chrische-xx/caravel_user_project_analog/README.md

# 8-bit SAR-ADC with offset calibration

This is a mixed-mode project featuring a 8-bit SAR-ADC, with offset calibration.
The logic section is synthesized using the openlane digital flow.

## Silicon Measurements 

Measurement results from the first measured die that was taped-out on the [MPW3 Shuttle](https://platform.efabless.com/shuttles/MPW-3)

```
Measurement Conditions:
AVDD=1.5V
DVDD=1.5V
VCM=0.75V
No offset calibration.
```

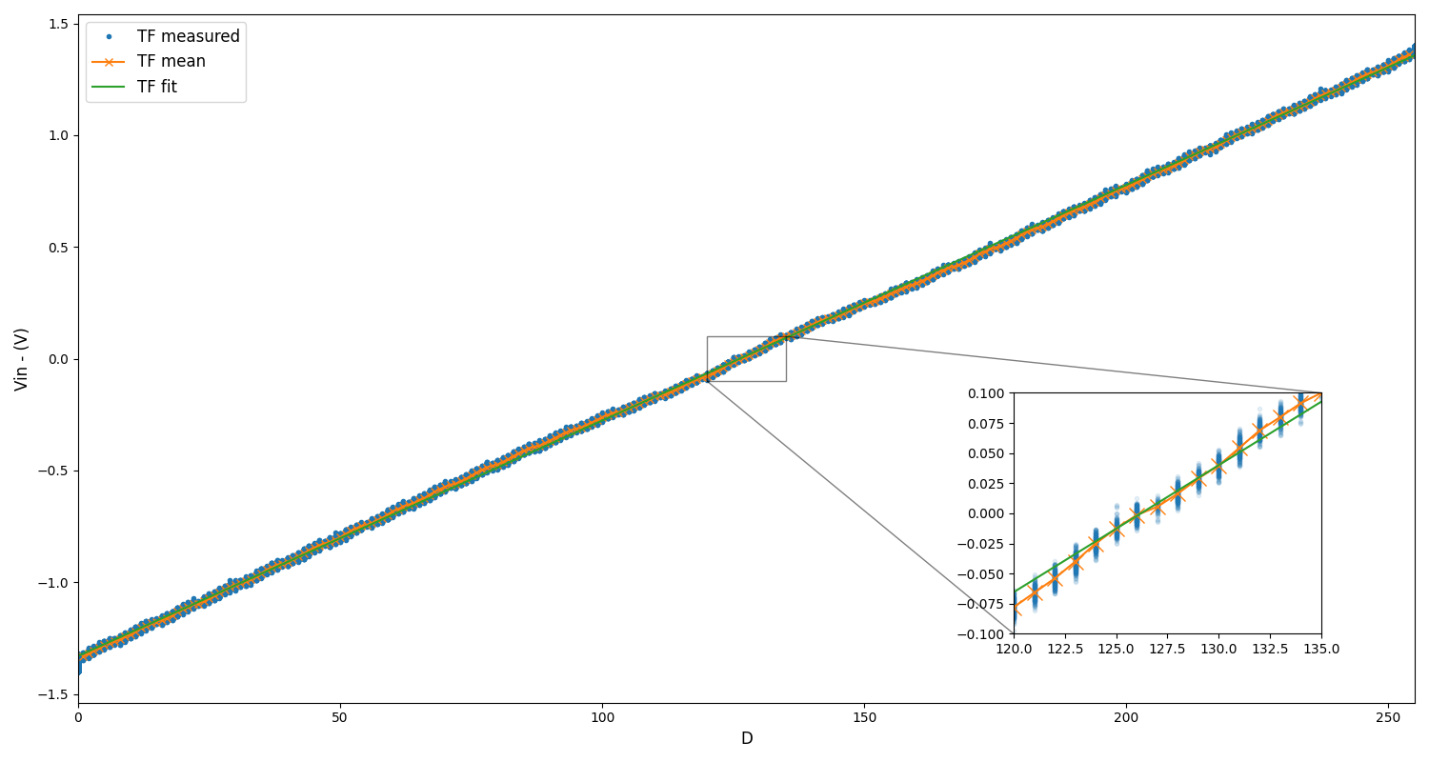
[picture p1: docs/pictures/silicon/tf.png]
TF


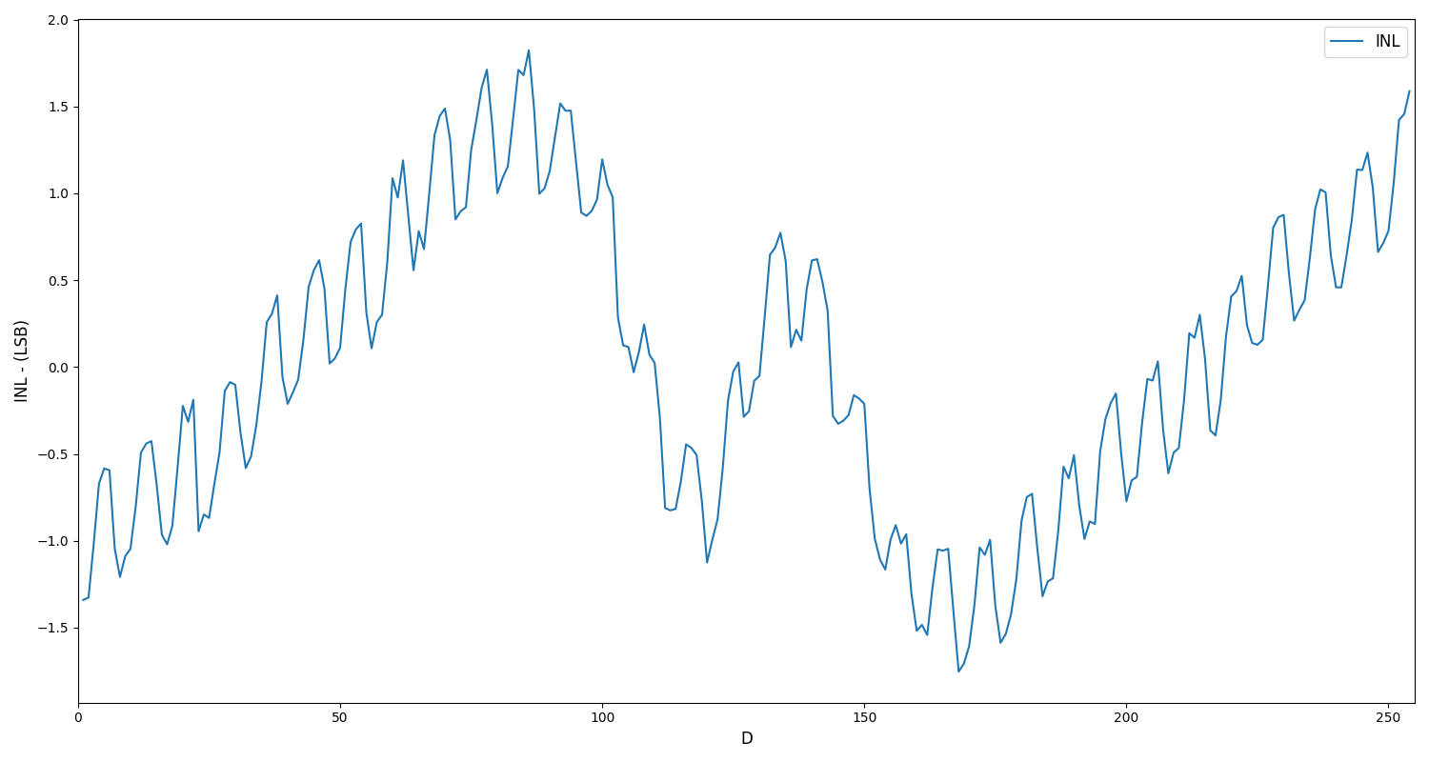
[picture p2: docs/pictures/silicon/inl.png]
INL


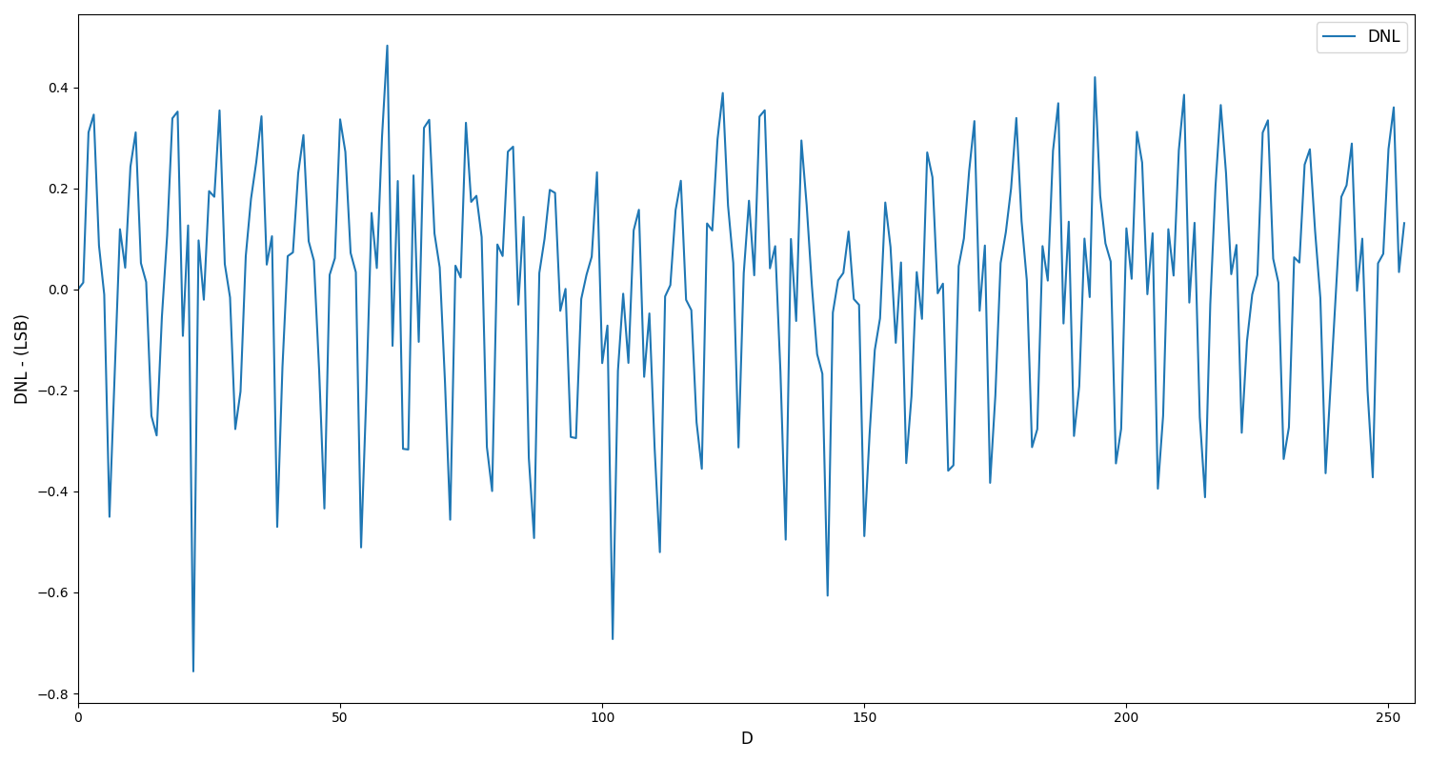
[picture p3: docs/pictures/silicon/dnl.png]
DNL


## Layout

The layout is created using magic as a pcell generator and drc checker, while the 
connection of the design is done using klayout.

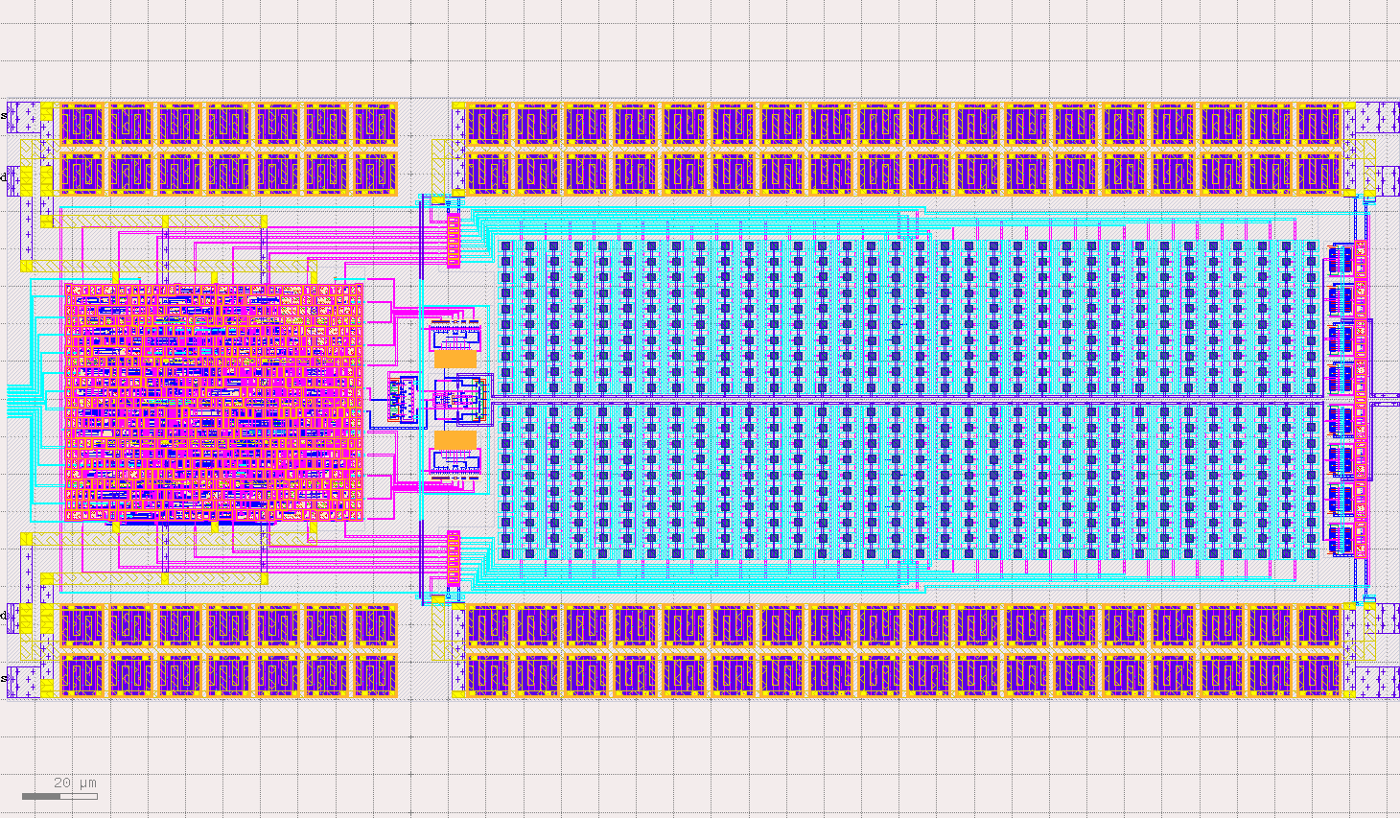
[picture p4: docs/layout.png]
layout


## Architecture

The ADC is composed of a differential top-plate sampled dac, which is made from an array of MIM capacitors.
The comparator is a regenerative comparator, which is followed by a latch to retain the output state during
reset. The latch output is fed into the logic section, which performs the standard binary search algorithm. 

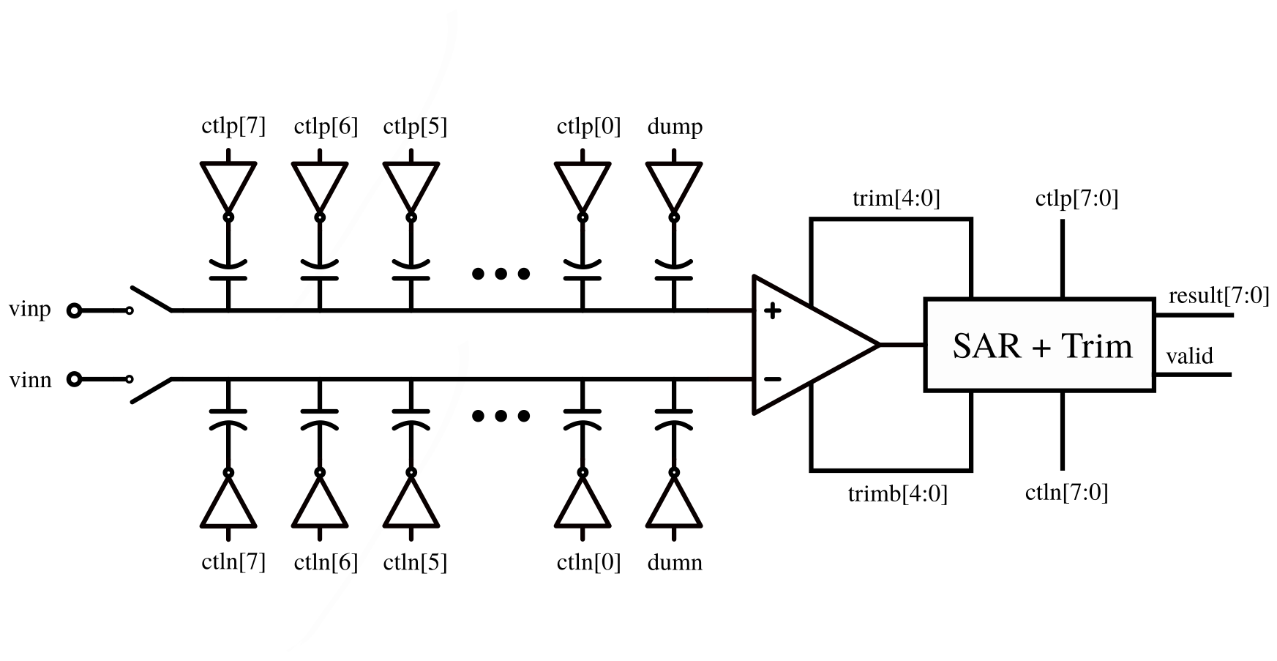
[picture p5: docs/pictures/architecture.png]


## Simulation

The simulation is carried out using ngspice using the mixed-mode xspice capabilities.
The digital section is synthesized using yosys that can then be bridged to/from the
analog section.

The Schematics are created using xschem, which also serves as the simulation framework.
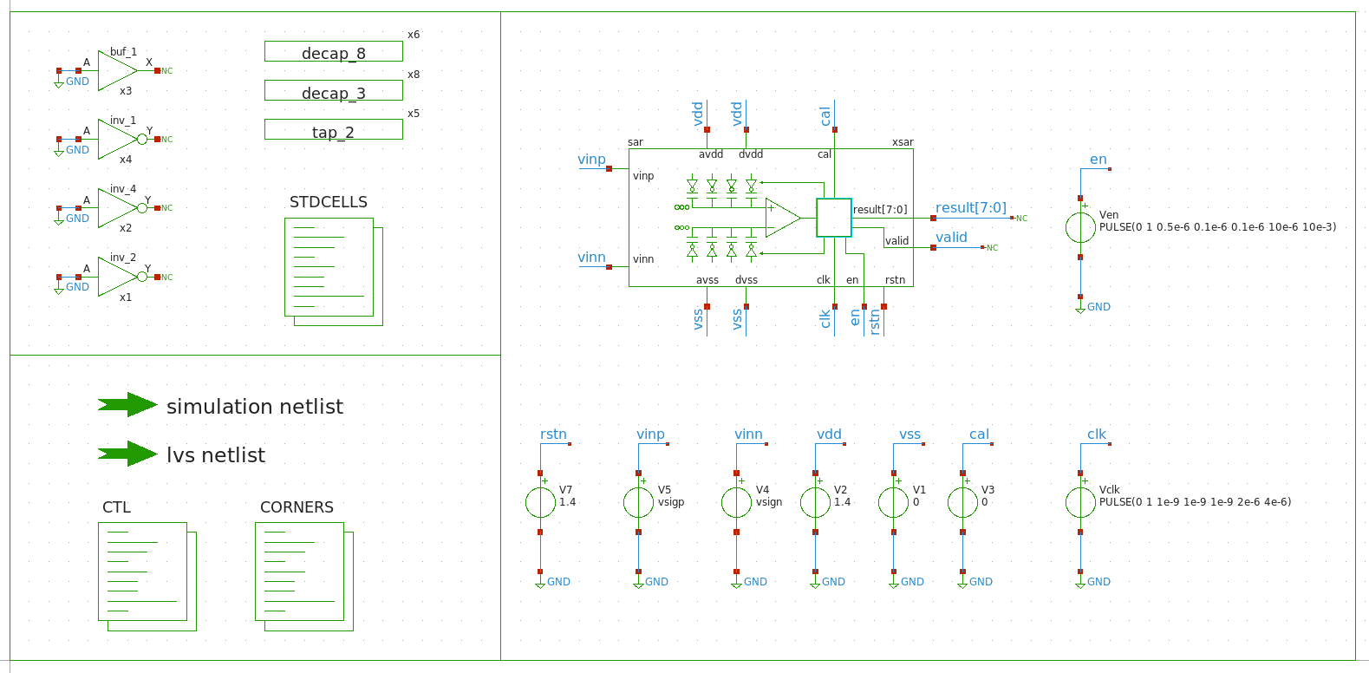
[picture p6: docs/pictures/xschem.png]


The SAR schematic:
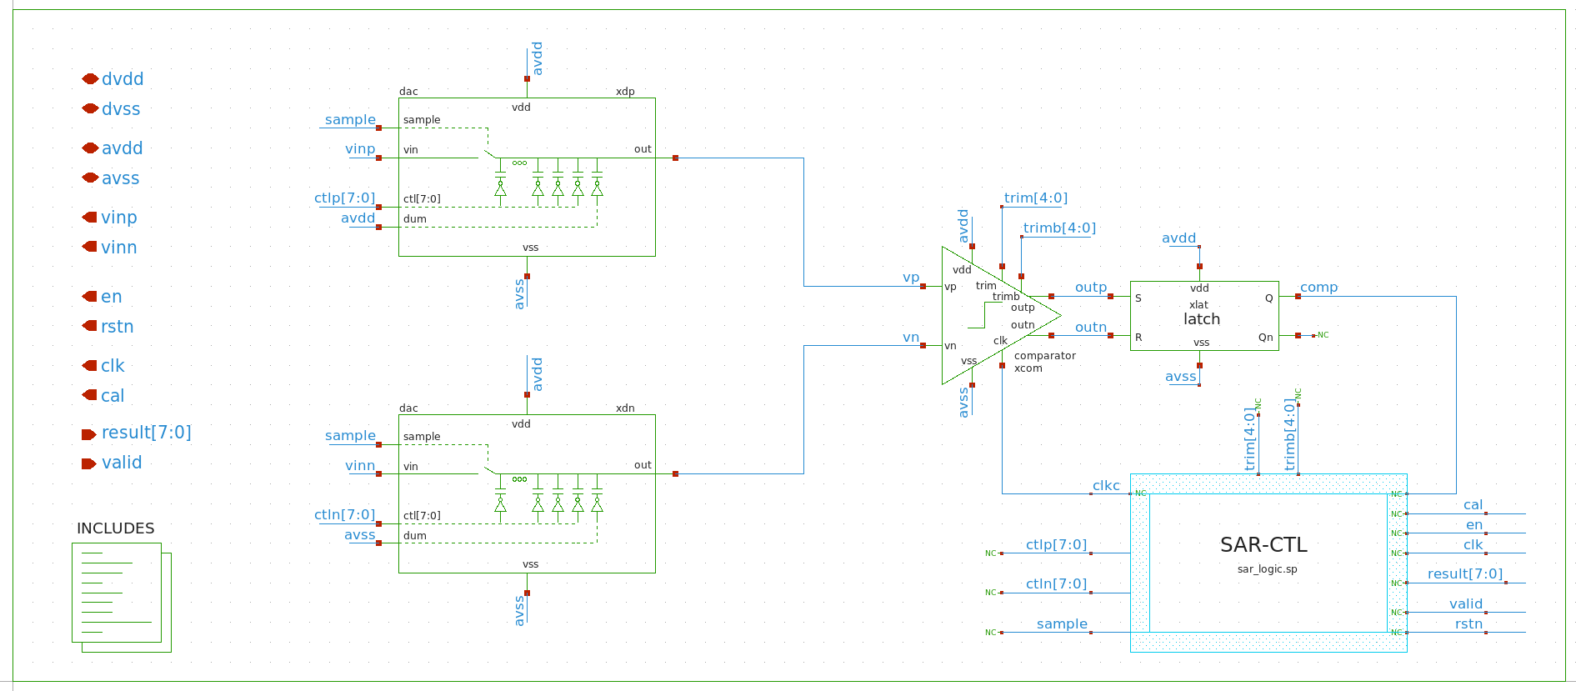
[picture p7: docs/pictures/sar.png]


The simulation output can then be viewed in both analog and digital domain.

Digital waveforms displayed using GTKWave
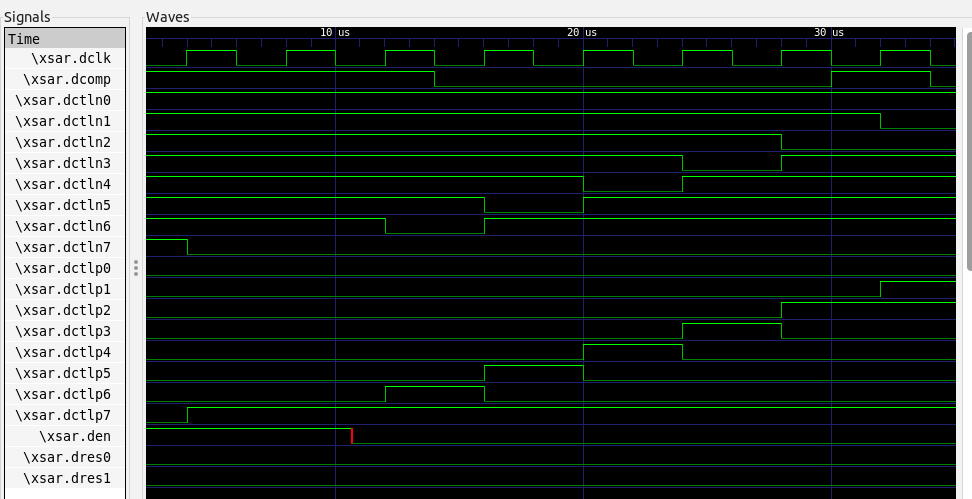
[picture p8: docs/pictures/gtkwave.png]
gtkwave


Analog waveforms displayed using Gnuplot in interactive mode.
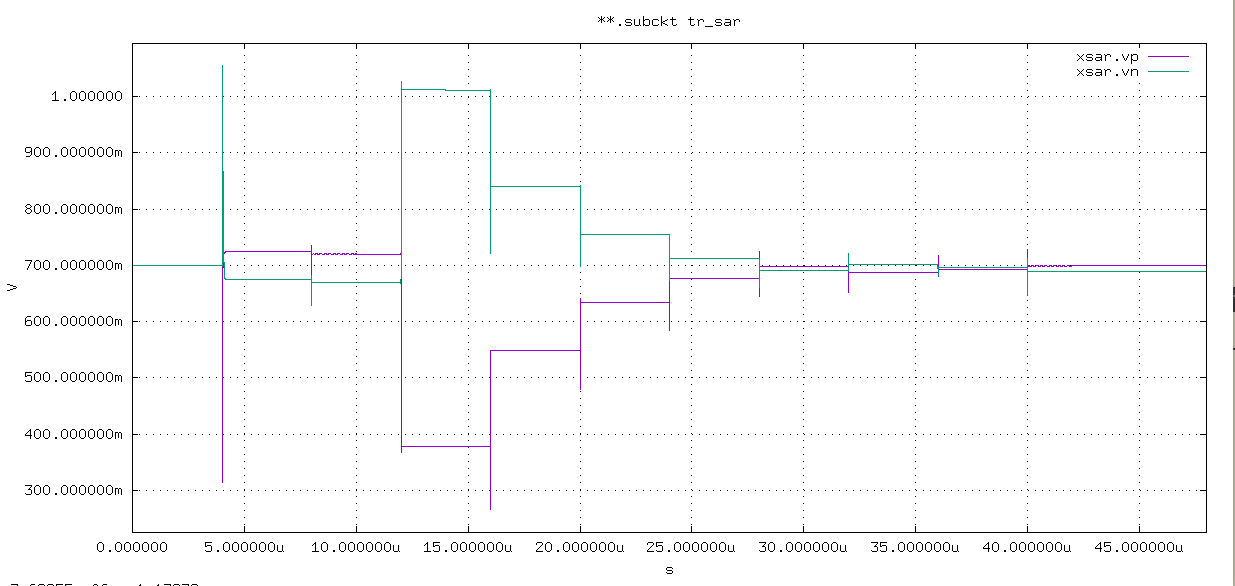
[picture p9: docs/pictures/gnuplot.png]
