chrische-xx/caravel_user_project_analog/xschem/sar/control/sar_logic.sp

* SPICE netlist generated by Yosys 0.8 (git sha1 5706e90)

.SUBCKT sar_logic clk rstn en comp cal valid result.0 result.1 result.2 result.3 result.4 result.5 result.6 result.7 sample ctlp.0 ctlp.1 ctlp.2 ctlp.3 ctlp.4 ctlp.5 ctlp.6 ctlp.7 ctln.0 ctln.1 ctln.2 ctln.3 ctln.4 ctln.5 ctln.6 ctln.7 trim.0 trim.1 trim.2 trim.3 trim.4 trimb.0 trimb.1 trimb.2 trimb.3 trimb.4 clkc
X0 rstn 1 NOT
X1 en 2 NOT
X2 cal_count.2 3 NOT
X3 cal_count.3 4 NOT
X4 en_co_clk 5 NOT
X5 trim_mask.0 6 NOT
X6 trim_val.4 7 NOT
X7 state.0 8 NOT
X8 state.1 9 NOT
X9 state.2 10 NOT
X10 result.0 11 NOT
X11 result.1 12 NOT
X12 result.2 13 NOT
X13 result.3 14 NOT
X14 result.4 15 NOT
X15 result.5 16 NOT
X16 result.6 17 NOT
X17 result.7 18 NOT
X18 cal_itt.1 19 NOT
X19 cal_itt.2 20 NOT
X20 cal_itt.3 21 NOT
X21 state.0 state.1 22 NOR
X22 8 9 23 NAND
X23 state.2 22 24 NAND
X24 24 valid NOT
X25 state.0 state.2 25 NOR
X26 25 26 NOT
X27 state.1 25 27 NAND
X28 27 28 NOT
X29 8 state.1 29 NOR
X30 state.0 9 30 NAND
X31 10 30 31 NOR
X32 state.2 29 32 NAND
X33 27 32 sample NAND
X34 cal_itt.0 cal_itt.1 33 NAND
X35 33 34 NOT
X36 20 33 35 NOR
X37 cal_itt.2 34 36 NAND
X38 cal_itt.3 36 37 NOR
X39 21 35 38 NAND
X40 6 38 39 NOR
X41 trim_mask.0 37 40 NAND
X42 cal_itt.0 40 41 NAND
X43 31 41 42 NAND
X44 en state.2 43 NOR
X45 43 44 NOT
X46 30 43 45 NOR
X47 29 44 46 NAND
X48 cal_itt.0 46 47 NAND
X49 42 47 48.0 NAND
X50 cal_itt.0 cal_itt.1 49 NOR
X51 19 45 50 NOR
X52 33 39 51 NOR
X53 32 51 52 NOR
X54 50 52 53 NOR
X55 49 53 48.1 NOR
X56 20 33 54 NAND
X57 36 54 55 NAND
X58 40 55 56 NAND
X59 31 56 57 NAND
X60 cal_itt.2 46 58 NAND
X61 57 58 48.2 NAND
X62 8 state.2 59 NOR
X63 59 60 NOT
X64 state.2 30 61 NOR
X65 61 62 NOT
X66 2 62 63 NOR
X67 en 61 64 NAND
X68 31 35 65 NAND
X69 cal_itt.3 65 66 NAND
X70 63 66 48.3 NOR
X71 32 37 67 NOR
X72 31 38 68 NAND
X73 cal_count.0 68 69 NAND
X74 cal_count.0 state.2 70 NAND
X75 45 70 71 NAND
X76 69 71 72.0 NAND
X77 cal_count.1 45 73 NOR
X78 cal_count.0 cal_count.1 74 NAND
X79 comp 74 75 NAND
X80 cal_count.0 cal_count.1 76 NOR
X81 76 77 NOT
X82 comp 74 78 NOR
X83 78 79 NOT
X84 75 77 80 NAND
X85 78 80 81 NOR
X86 comp 76 82 NAND
X87 67 82 83 NAND
X88 81 83 84 NOR
X89 73 84 72.1 NOR
X90 cal_count.2 45 85 NOR
X91 79 82 86 NAND
X92 3 86 87 NAND
X93 67 87 88 NAND
X94 3 86 89 NOR
X95 88 89 90 NOR
X96 85 90 72.2 NOR
X97 cal_count.3 46 91 NAND
X98 cal_count.2 78 92 NAND
X99 92 93 NOT
X100 cal_count.2 82 94 NOR
X101 94 95 NOT
X102 93 94 96 NOR
X103 92 95 97 NAND
X104 4 97 98 NAND
X105 cal_count.3 96 99 NAND
X106 98 99 100 NAND
X107 67 100 101 NAND
X108 91 101 72.3 NAND
X109 5 64 102 NAND
X110 31 40 103 NAND
X111 9 60 104 NOR
X112 state.1 59 105 NAND
X113 mask.0 105 106 NOR
X114 61 106 107 NOR
X115 103 107 108 NAND
X116 102 108 109 NAND
X117 5 29 110 NOR
X118 60 110 111 NAND
X119 109 111 112 NAND
X120 calibrate 27 113 NOR
X121 26 113 114 NOR
X122 32 38 115 NOR
X123 31 37 116 NAND
X124 trim_mask.0 115 117 NAND
X125 4 117 118 NOR
X126 trim_val.0 118 119 NOR
X127 114 119 120.0 NOR
X128 trim_mask.1 115 121 NAND
X129 4 121 122 NOR
X130 trim_val.1 122 123 NOR
X131 114 123 120.1 NOR
X132 trim_mask.2 115 124 NAND
X133 4 124 125 NOR
X134 trim_val.2 125 126 NOR
X135 114 126 120.2 NOR
X136 trim_mask.3 115 127 NAND
X137 4 127 128 NOR
X138 trim_val.3 128 129 NOR
X139 114 129 120.3 NOR
X140 state.2 23 130 NOR
X141 7 114 131 NOR
X142 130 131 132 NOR
X143 trim_mask.4 115 133 NAND
X144 133 134 NOT
X145 cal_count.3 134 135 NAND
X146 132 135 120.4 NAND
X147 calibrate 28 136 NAND
X148 32 136 137 NAND
X149 68 137 138 NAND
X150 trim_mask.0 138 139 NAND
X151 121 139 140.0 NAND
X152 trim_mask.1 138 141 NAND
X153 124 141 140.1 NAND
X154 trim_mask.2 138 142 NAND
X155 127 142 140.2 NAND
X156 trim_mask.3 138 143 NAND
X157 133 143 140.3 NAND
X158 trim_mask.4 116 144 NAND
X159 136 144 140.4 NAND
X160 mask.1 104 145 NAND
X161 29 43 146 NAND
X162 59 146 147 NAND
X163 mask.0 147 148 NAND
X164 145 148 149.0 NAND
X165 mask.2 104 150 NAND
X166 mask.1 147 151 NAND
X167 150 151 149.1 NAND
X168 mask.3 104 152 NAND
X169 mask.2 147 153 NAND
X170 152 153 149.2 NAND
X171 mask.4 104 154 NAND
X172 mask.3 147 155 NAND
X173 154 155 149.3 NAND
X174 mask.5 104 156 NAND
X175 mask.4 147 157 NAND
X176 156 157 149.4 NAND
X177 mask.6 104 158 NAND
X178 mask.5 147 159 NAND
X179 158 159 149.5 NAND
X180 mask.7 104 160 NAND
X181 mask.6 147 161 NAND
X182 160 161 149.6 NAND
X183 mask.7 63 162 NOR
X184 104 162 149.7 NOR
X185 23 27 163 NAND
X186 state.1 state.2 164 NAND
X187 164 165 NOT
X188 103 164 166 NAND
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
X329 clk 72.3 cal_count.3 0s 233 DFFSR
X330 clk 48.0 cal_itt.0 0s 234 DFFSR
X331 clk 48.1 cal_itt.1 0s 235 DFFSR
X332 clk 48.2 cal_itt.2 0s 236 DFFSR
X333 clk 48.3 cal_itt.3 0s 1 DFFSR
.ENDS sar_logic

************************
* end of SPICE netlist *
************************
