chrische-xx/caravel_user_project_analog/(commit log)

2021-11-12 added key testbenches, schematics etc.
    [analog_wrapper_tb.sch, carray.sch, comparator.sch, dac.sch, example_por.sch, example_por_tb.sch, latch.sch, sar.sch]
2021-11-14 layout matches top-level schematic
    [user_analog_project_wrapper.sch]
2021-11-14 added config.tcl + pin.cfg for openlane flow
    [pin.cfg]
2021-11-14 fixed wrong label
    [user_analog_project_wrapper.sch]
2021-11-24 general improvements for project startup
    [user_analog_project_wrapper.sch]
2021-11-24 fixed some references in testbenches
    [tr_sar.sch, tran_comparator_trim.sch]
2021-11-24 fixed some more missing references
    [carray.sch, inv_lvt.sch]
2021-11-24 updated more references
    [carray.sch, dac.sch, latch.sch, sw_top.sch, trim.sch]
